wheeler-microfluidics/kicad___hv513_breakout/(commit log)

2016-01-29 Adjust design rules for milling
    [hv513_breakout.kicad_pcb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]
2016-01-29 Add high pass filters
    [hv513_breakout.kicad_pcb, hv513_breakout.sch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]
2016-02-04 Add edge cuts
    [hv513_breakout-B.Cu.gbr, hv513_breakout-B.Mask.gbr, hv513_breakout-B.SilkS.gbr, hv513_breakout-B_Cu.gbr, hv513_breakout-B_SilkS.gbr, hv513_breakout-Edge.Cuts.gbr, hv513_breakout-Edge_Cuts.gbr, hv513_breakout-F.Cu.gbr]
2016-02-04 Minor modifications to trace paths
    [hv513_breakout.kicad_pcb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]
